dsaidyB/Etch-A-Sketch_Coop_Project/release/eBom Dhyey Bhatt AlumaPower Etch-A-Sketch.xlsx

Total Cost: | $196.98 | < $200
 | Reference | Value | Part Number | Description | Quantity | Unit Cost (CAD) | Total Cost (CAD) | Link | Comments | Status
1 | BT101 | KE_3034TR | 3034TR | BATTERY RETAINER COIN 20MM SMD | 1 | $0.59 | $0.59 | https://www.digikey.ca/en/products/detail/keystone-electronics/3034TR/4499408
2 | C101 | 4.7uF | GRM188Z71C475KE21J | CAP CER 4.7UF 16V X7R 0603 | 1 | $0.21 | $0.21 | https://www.digikey.ca/en/products/detail/murata-electronics/GRM188Z71C475KE21J/16033436
3 | C102, C103, C106, C108, C111, C112, C114 | 100nF | CC0603KRX7R7BB104 | CAP CER 0.1UF 16V X7R 0603 | 7 | $0.01 | $0.07 | https://www.digikey.ca/en/products/detail/yageo/CC0603KRX7R7BB104/302822
4 | C104, C105, C107, C115, C118 | 1uF | CL10B105KO8NNNC | CAP CER 1UF 16V X7R 0603 | 5 | $0.01 | $0.05 | https://www.digikey.ca/en/products/detail/samsung-electro-mechanics/CL10B105KO8NNNC/3886677
5 | C109 | 10pF | C0402C100K5RACTU | CAP CER 10PF 50V X7R 0402 | 1 | $0.06 | $0.06 | https://www.digikey.ca/en/products/detail/kemet/C0402C100K5RACTU/10483038
6 | C110 | 22nF | CL10B223KB8WPNC | CAP CER 0.022UF 50V X7R 0603 | 1 | $0.06 | $0.06 | https://www.digikey.ca/en/products/detail/samsung-electro-mechanics/CL10B223KB8WPNC/5961018
7 | C113, C116, C117, C119, C120 | 10uF | GRM188Z71A106KA73D | CAP CER 10UF 10V X7R 0603 | 5 | $0.25 | $1.25 | https://www.digikey.ca/en/products/detail/murata-electronics/GRM188Z71A106KA73D/13401725
8 | D101 | EE_EAST1616RGBB2 | EAST1616RGBB2 | LED RGB DIFFUSED 4SMD | 1 | $0.35 | $0.35 | https://www.digikey.ca/en/products/detail/everlight-electronics-co-ltd/EAST1616RGBB2/8510360
9 | H101-H108 | MountingHole | N/A |  | 8 |  | $0.00
10 | J101 | SAM_FTSH-107-01-L-DV-K-A_STDC14 | FTSH-107-01-L-DV-K-A | CONN HEADER SMD 14POS 1.27MM | 1 | $4.78 | $4.78 | https://www.digikey.ca/en/products/detail/samtec-inc/FTSH-107-01-L-DV-K-A/7443623 | STDC14
11 | J102 | WE_61304021121 | 61304021121 | CONN HEADER VERT 40POS 2.54MM | 1 | $2.70 | $2.70 | https://www.digikey.ca/en/products/detail/w%C3%BCrth-elektronik/61304021121/4846886
12 | L101, L102 | 600R@100MHz | BLM18AG601SN1D | FERRITE BEAD 600 OHM 0603 1LN | 2 | $0.09 | $0.18 | https://www.digikey.ca/en/products/detail/murata-electronics/BLM18AG601SN1D/584225
13 | R101, R102 | 147R | RC0603FR-07147RL | RES 147 OHM 1% 1/10W 0603 | 2 | $0.01 | $0.02 | https://www.digikey.ca/en/products/detail/yageo/RC0603FR-07147RL/726950
14 | R103 | 1K | RMCF0603FT1K00 | RES 1K OHM 1% 1/10W 0603 | 1 | $0.01 | $0.01 | https://www.digikey.ca/en/products/detail/stackpole-electronics-inc/RMCF0603FT1K00/1761077
15 | R104 | 511R | RC0603FR-07511RL | RES 511 OHM 1% 1/10W 0603 | 1 | $0.01 | $0.01 | https://www.digikey.ca/en/products/detail/yageo/RC0603FR-07511RL/727287
16 | R105, R110, R111 | 10K | RC0603FR-0710KL | RES 10K OHM 1% 1/10W 0603 | 3 | $0.01 | $0.03 | https://www.digikey.ca/en/products/detail/yageo/RC0603FR-0710KL/726880
17 | R106, R107 | TTE_P120PK-Y25BR10K | P120PK-Y25BR10K | POT 10K OHM 1/20W PLASTIC LINEAR | 2 | $1.79 | $3.58 | https://www.digikey.ca/en/products/detail/tt-electronics-bi/P120PK-Y25BR10K/5957454
18 | R108 | 59K | RC0603FR-0759KL | RES 59K OHM 1% 1/10W 0603 | 1 | $0.01 | $0.01 | https://www.digikey.ca/en/products/detail/yageo/RC0603FR-0759KL/727313
19 | R109, R114, R115 | 100K | RC0603FR-07100KL | RES 100K OHM 1% 1/10W 0603 | 3 | $0.01 | $0.03 | https://www.digikey.ca/en/products/detail/yageo/RC0603FR-07100KL/726889
20 | R112, R113 | 23.2K | RC0603FR-0723K2L | RES 23.2K OHM 1% 1/10W 0603 | 2 | $0.01 | $0.02 | https://www.digikey.ca/en/products/detail/yageo/RC0603FR-0723K2L/727068
21 | SW101 | CK_GSPTS004003 | GSPTS004003 | SWITCH TACTILE SPST-NO 0.05A 12V | 1 | $0.28 | $0.28 | https://www.digikey.ca/en/products/detail/c-k/PTS636SM43SMTR-LFS/10071723
22 | SW102 | ESW_RA11131121 | RA11131121 | SWITCH ROCKER SPST 10A 125V | 1 | $0.92 | $0.92 | https://www.digikey.ca/en/products/detail/e-switch/RA11131121/2720267
23 | TP101 | GND | N/A |  | 1 |  | $0.00
24 | TP102 | VCC_3V | N/A |  | 1 |  | $0.00
25 | TP103 | VCC_3V_OUT | N/A |  | 1 |  | $0.00
26 | TP104 | VCC_3V3 | N/A |  | 1 |  | $0.00
27 | TP105 | VCC_5V | N/A |  | 1 |  | $0.00
28 | U101 | STM32L433CCT6 | STM32L433CCT6 | IC MCU 32BIT 256KB FLASH 48LQFP | 1 | $8.21 | $8.21 | https://www.digikey.ca/en/products/detail/stmicroelectronics/STM32L433CCT6/6132750
29 | U102 | TI_TPS2553DBVT | TPS2553DBVT | IC PWR SWITCH N-CHAN 1:1 SOT23-6 | 1 | $1.81 | $1.81 | https://www.digikey.ca/en/products/detail/texas-instruments/TPS2553DBVT/1984893
30 | U103 | ST_LIS2DW12TR | LIS2DW12TR | ACCEL 2-16G I2C/SPI 12LGA | 1 | $2.07 | $2.07 | https://www.digikey.ca/en/products/detail/stmicroelectronics/LIS2DW12TR/7348326
31 | U104, U105 | MIC_MCP1253T-33X50I/MS | MCP1253T-33X50I/MS | IC REG CHARGE PUMP PROG 1 8MSOP | 2 | $2.94 | $5.88 | https://www.digikey.ca/en/products/detail/microchip-technology/MCP1253T-33X50I-MS/530263
32 |  |  | 17590 | 6inch HD e-Paper HAT | 1 | $157.85 | $157.85 | https://www.waveshare.com/6inch-HD-e-Paper-HAT.htm |  | Ordered
33 |  |  | #065-3123-6 | CR2032 3V Coin Cell Battey, Long Lasting | 1 | $2.83 | $2.83 | https://www.canadiantire.ca/en/pdp/energizer-6-pk-cr2032-3v-3-volt-lithium-coin-cell-batteries-long-lasting-0653123p.html | 6 pack
34 | L101, L102 |  | BLM18KG121TN1D | FERRITE BEAD 120 OHM 0603 1LN | 2 | $0.10 | $0.20 | https://www.digikey.ca/en/products/detail/murata-electronics/BLM18KG121TN1D/1982762
35 | J102 |  | PPPC202LFBN-RC | CONN HDR 40POS 0.1 GOLD PCB | 1 | $2.92 | $2.92 | https://www.digikey.ca/en/products/detail/sullins-connector-solutions/PPPC202LFBN-RC/810259
 |  |  |  |  |  |  | $0.00
 |  |  |  |  |  |  | $0.00
 |  |  |  |  |  |  | $0.00
 |  |  |  |  |  |  | $0.00
 |  |  |  |  |  |  | $0.00
 |  |  |  |  |  |  | $0.00
 |  |  |  |  |  | Total Cost (CAD): | $196.98
