dsaidyB/Etch-A-Sketch_Coop_Project/etch_a_sketch/etch_a_sketch.kicad_pcb

## KiCad design etch_a_sketch/etch_a_sketch.kicad_pcb (2025-12-12)

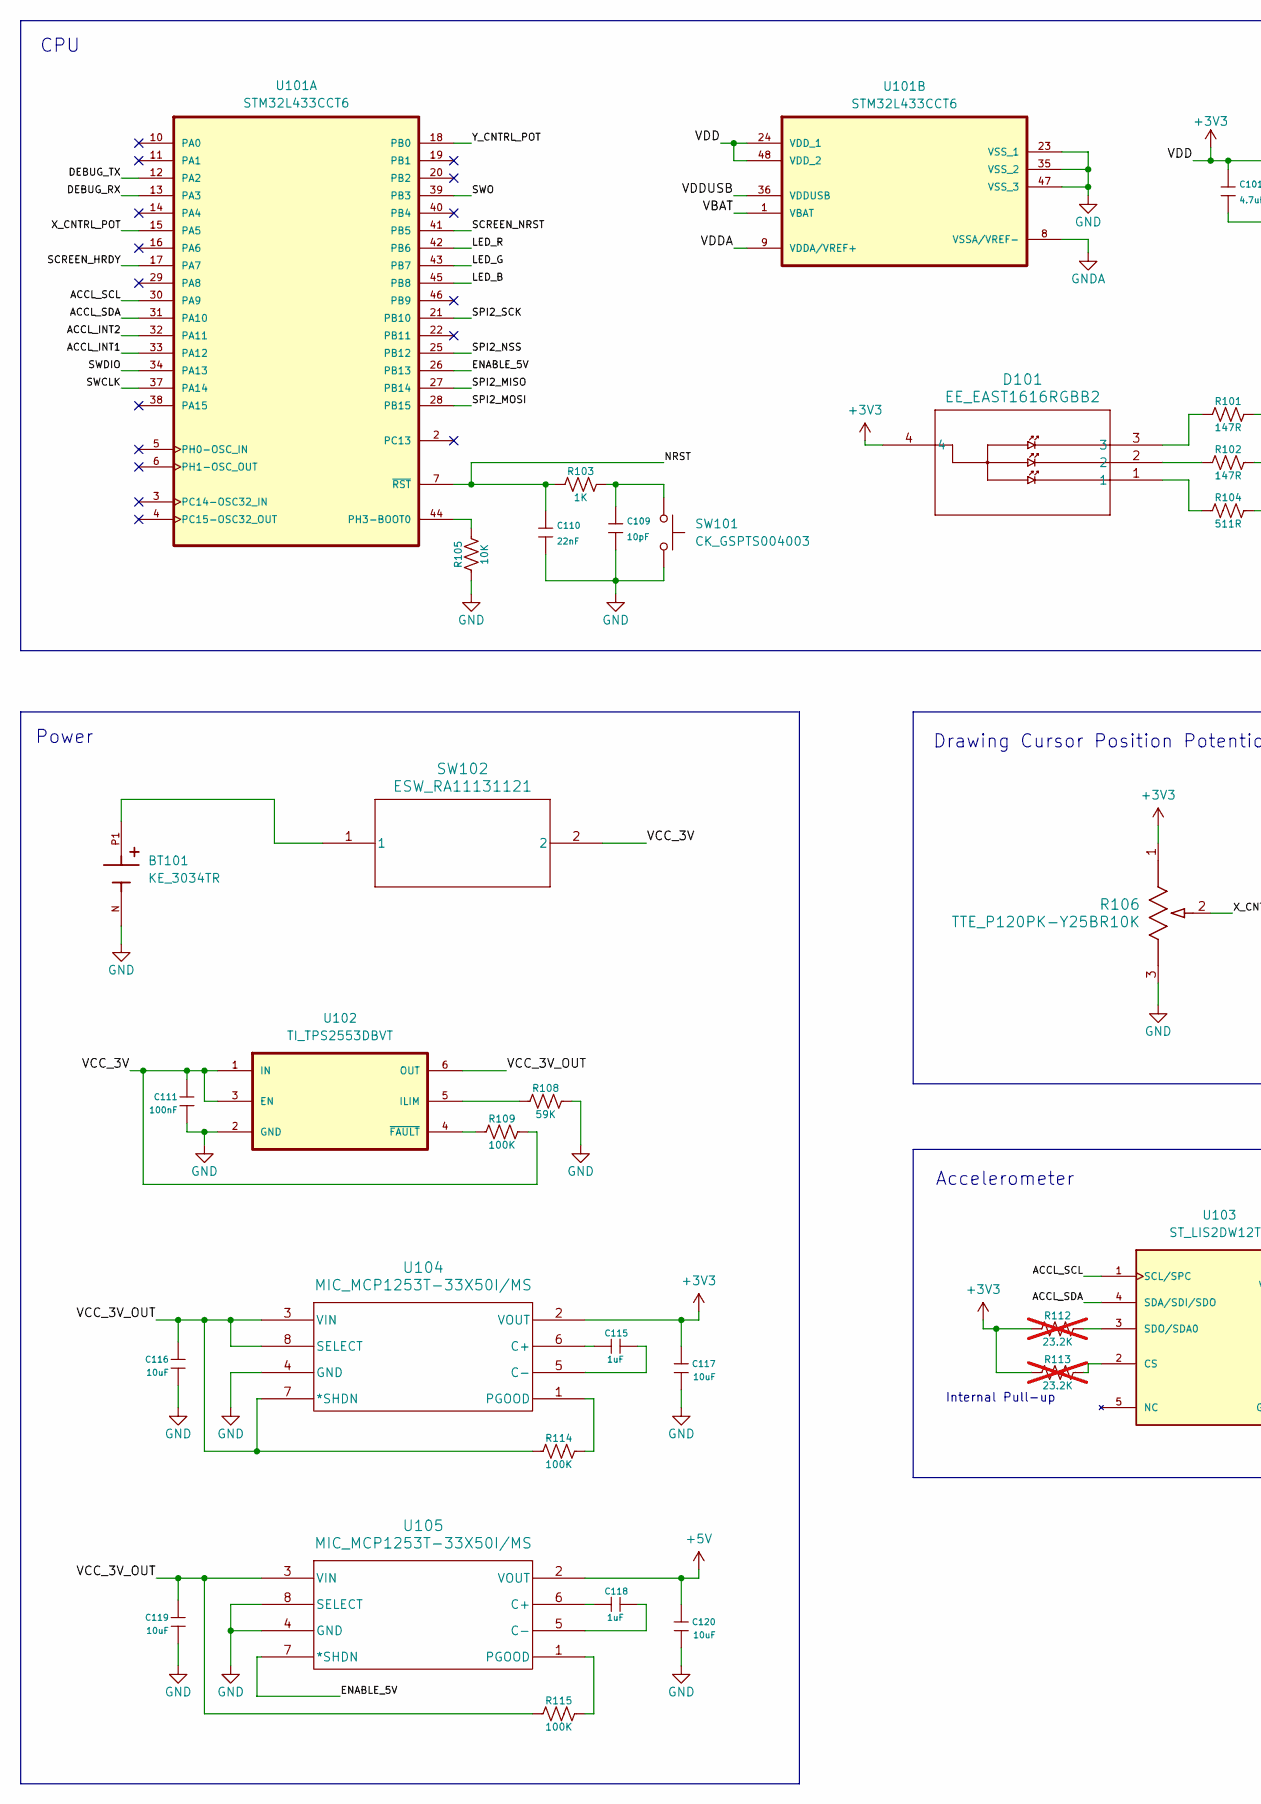
[picture p1: schematic etch_a_sketch.kicad_sch, Dhyey B. Etch-A-Sketch AlumaPower Co-op Project, part in row 1, column 1]

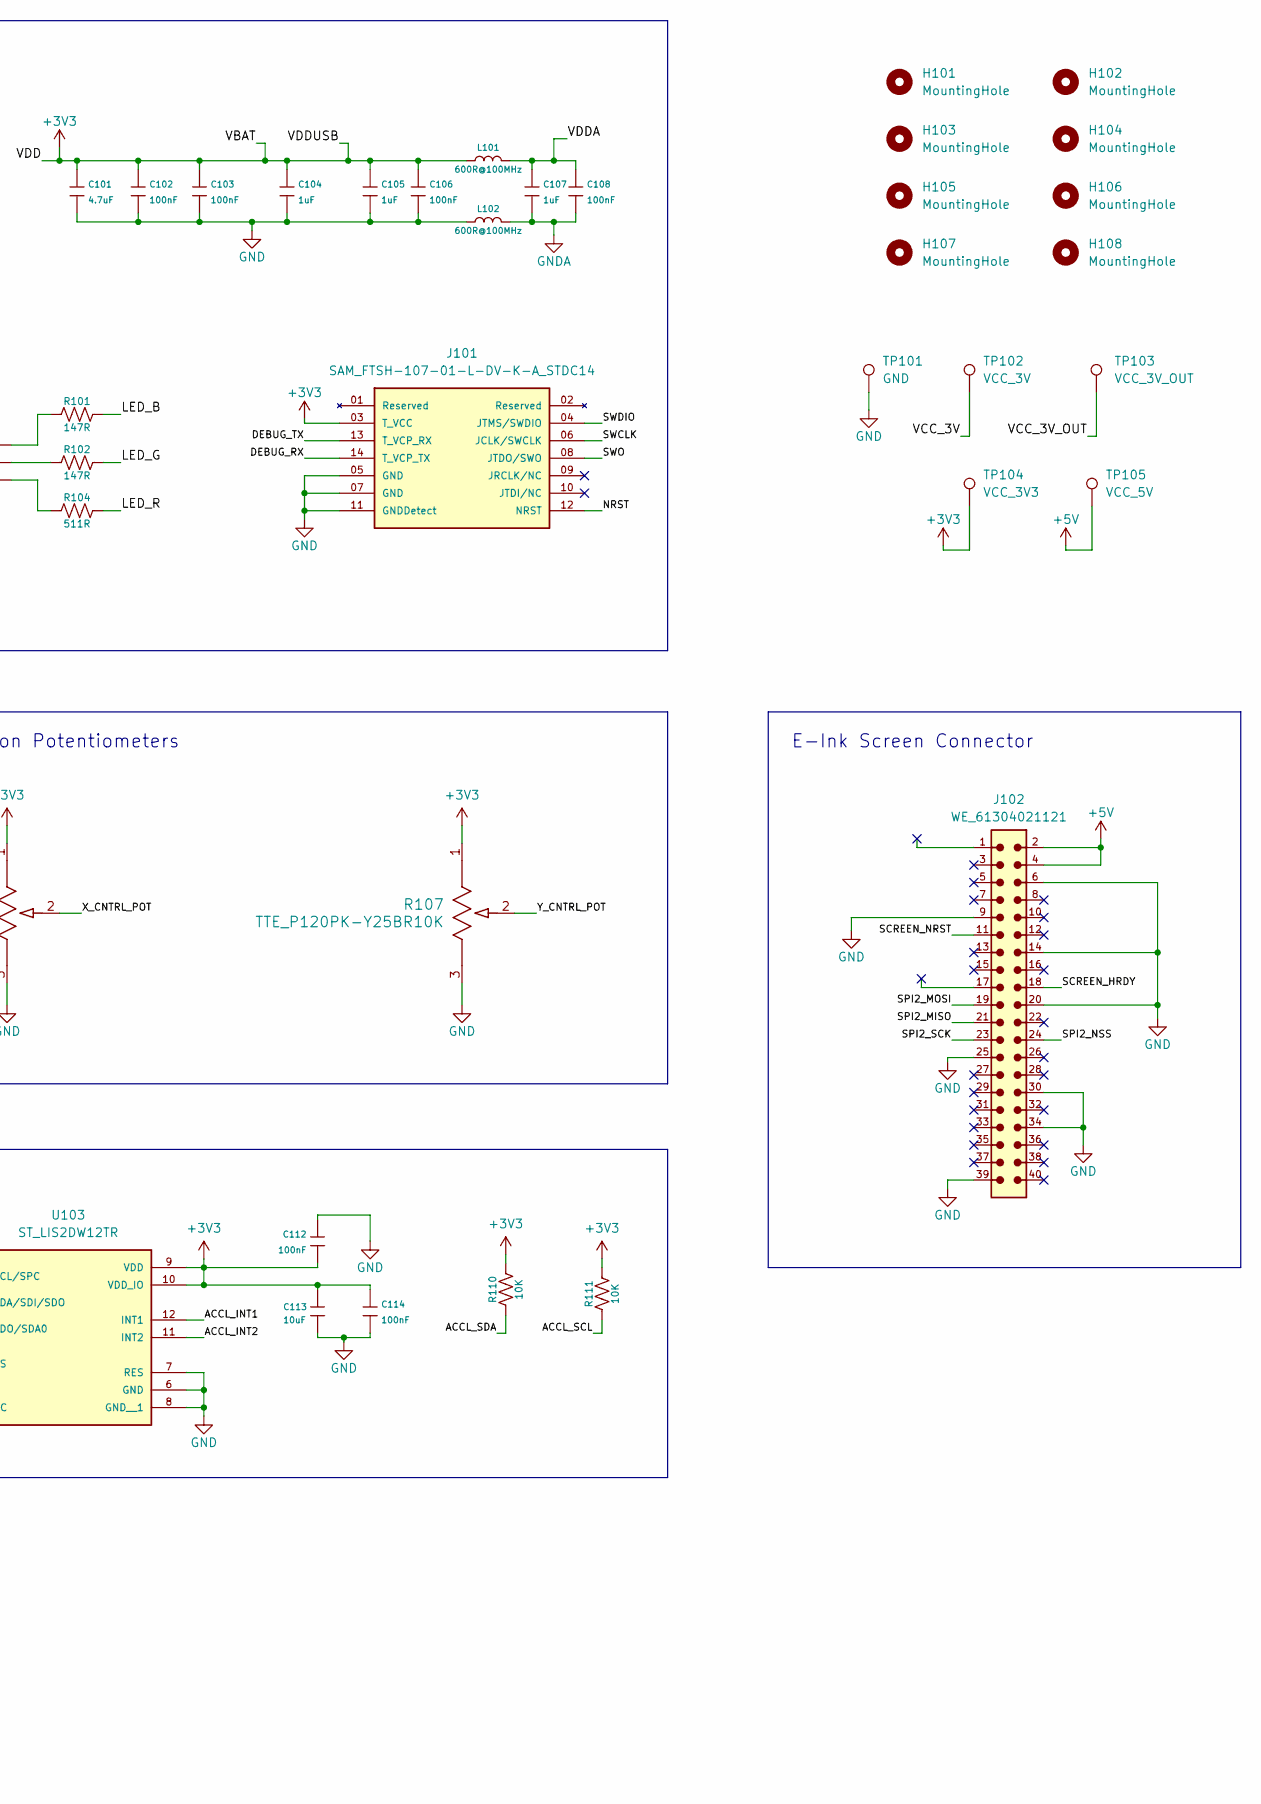
[picture p2: schematic etch_a_sketch.kicad_sch, Dhyey B. Etch-A-Sketch AlumaPower Co-op Project, part in row 1, column 2]

Parts:
BT101: KE_3034TR; PARTREV E; DigiKey_Part_Number 36-3034CT-ND
C101: 4.7uF; 0603_1608Metric
C102, C103, C106, C108, C111, C112, C114: 100nF; 0603_1608Metric
C104, C105, C107, C115, C118: 1uF; 0603_1608Metric
C109: 10pF; 0402_1005Metric
C110: 22nF; 0603_1608Metric
C113, C116, C117, C119, C120: 10uF; 0603_1608Metric
D101: EE_EAST1616RGBB2
H101, H102, H103, H104, H105, H106, H107, H108: MountingHole; MountingHole_3.2mm_M3_ISO14580_Pad_TopBottom
J101: SAM_FTSH-107-01-L-DV-K-A_STDC14; PARTREV H; DigiKey_Part_Number FTSH-107-01-L-DV-K-A-ND
J102: WE_61304021121
L101, L102: 600R@100MHz; 0603_1608Metric
R101, R102: 147R; 0603_1608Metric
R103: 1K; 0603_1608Metric
R104: 511R; 0603_1608Metric
R105, R110, R111: 10K; 0603_1608Metric
R106, R107: TTE_P120PK-Y25BR10K
R108: 59K; 0603_1608Metric
R109, R114, R115: 100K; 0603_1608Metric
R112, R113: 23.2K; 0603_1608Metric; not fitted
SW101: CK_GSPTS004003
SW102: ESW_RA11131121
TP101: GND; TestPoint_THTPad_4.0x4.0mm_Drill2.0mm
TP102: VCC_3V; TestPoint_THTPad_4.0x4.0mm_Drill2.0mm
TP103: VCC_3V_OUT; TestPoint_THTPad_4.0x4.0mm_Drill2.0mm
TP104: VCC_3V3; TestPoint_THTPad_4.0x4.0mm_Drill2.0mm
TP105: VCC_5V; TestPoint_THTPad_4.0x4.0mm_Drill2.0mm
U101: STM32L433CCT6
U102: TI_TPS2553DBVT; TI_TPS2553DBVT_SOT-23-6; DigiKey_Part_Number 296-23990-1-ND
U103: ST_LIS2DW12TR; PARTREV 4
U104, U105: MIC_MCP1253T-33X50I/MS; MIC_MCP1253T-33X50IMS

Connections:
+3V3: C101.1, C102.1, C103.1, C104.1, C105.1, C106.1, C112.2, C113.2, C114.1, C117.2, D101.4, J101.03 (T_VCC), L101.1, R106.1, R107.1, R110.2, R111.2, R112.1, R113.1, TP104.1, U101.1 (VBAT), U101.24 (VDD_1), U101.36 (VDDUSB), U101.48 (VDD_2), U103.9 (VDD), U103.10 (VDD_IO), U104.2 (VOUT)
+5V: C120.2, J102.2, J102.4, TP105.1, U105.2 (VOUT)
/ACCL_INT1: U101.33 (PA12), U103.12 (INT1)
/ACCL_INT2: U101.32 (PA11), U103.11 (INT2)
/ACCL_SCL: R111.1, U101.30 (PA9), U103.1 (SCL/SPC)
/ACCL_SDA: R110.1, U101.31 (PA10), U103.4 (SDA/SDI/SDO)
/DEBUG_RX: J101.14 (T_VCP_TX), U101.13 (PA3)
/DEBUG_TX: J101.13 (T_VCP_RX), U101.12 (PA2)
/ENABLE_5V: U101.26 (PB13), U105.7 (*SHDN)
/LED_B: R101.2, U101.45 (PB8)
/LED_G: R102.2, U101.43 (PB7)
/LED_R: R104.2, U101.42 (PB6)
/NRST: C110.1, J101.12 (NRST), R103.1, U101.7 (~RST)
/SCREEN_HRDY: J102.18, U101.17 (PA7)
/SCREEN_NRST: J102.11, U101.41 (PB5)
/SPI2_MISO: J102.21, U101.27 (PB14)
/SPI2_MOSI: J102.19, U101.28 (PB15)
/SPI2_NSS: J102.24, U101.25 (PB12)
/SPI2_SCK: J102.23, U101.21 (PB10)
/SWCLK: J101.06 (JCLK/SWCLK), U101.37 (PA14)
/SWDIO: J101.04 (JTMS/SWDIO), U101.34 (PA13)
/SWO: J101.08 (JTDO/SWO), U101.39 (PB3)
/VCC_3V: C111.2, R109.2, SW102.2, TP102.1, U102.1 (IN), U102.3 (EN)
/VCC_3V_OUT: C116.2, C119.2, R114.1, R115.1, TP103.1, U102.6 (OUT), U104.3 (VIN), U104.7 (*SHDN), U104.8 (SELECT), U105.3 (VIN)
/VDDA: C107.1, C108.1, L101.2, U101.9 (VDDA/VREF+)
/X_CNTRL_POT: R106.2, U101.15 (PA5)
/Y_CNTRL_POT: R107.2, U101.18 (PB0)
GND: BT101.N, C101.2, C102.2, C103.2, C104.2, C105.2, C106.2, C109.2, C110.2, C111.1, C112.1, C113.1, C114.2, C116.1, C117.1, C119.1, C120.1, J101.05 (GND), J101.07 (GND), J101.11 (GNDDetect), J102.6, J102.9, J102.14, J102.20, J102.25, J102.30, J102.34, J102.39, L102.1, R105.1, R106.3, R107.3, R108.2, SW101.2, TP101.1, U101.23 (VSS_1), U101.35 (VSS_2), U101.47 (VSS_3), U102.2 (GND), U103.6 (GND), U103.7 (RES), U103.8 (GND__1), U104.4 (GND), U105.4 (GND), U105.8 (SELECT)
GNDA: C107.2, C108.2, L102.2, U101.8 (VSSA/VREF-)
unnamed: BT101.P1, BT101.P2, SW102.1
unnamed: C109.1, R103.2, SW101.1
unnamed: D101.1, R104.1
unnamed: D101.2, R102.1
unnamed: D101.3, R101.1
unnamed: R105.2, U101.44 (PH3-BOOT0)
unnamed: R108.1, U102.5 (ILIM)
unnamed: R109.1, U102.4 (~FAULT)
unnamed: R113.2, U103.2 (CS)
unnamed: R112.2, U103.3 (SDO/SDA0)
unnamed: C115.1, U104.6 (C+)
unnamed: C115.2, U104.5 (C-)
unnamed: R114.2, U104.1 (PGOOD)
unnamed: C118.1, U105.6 (C+)
unnamed: C118.2, U105.5 (C-)
unnamed: R115.2, U105.1 (PGOOD)

Notes on the sheet:
Internal Pull-up
Drawing Cursor Position Potentiometers
Accelerometer
CPU
Power
E-Ink Screen Connector

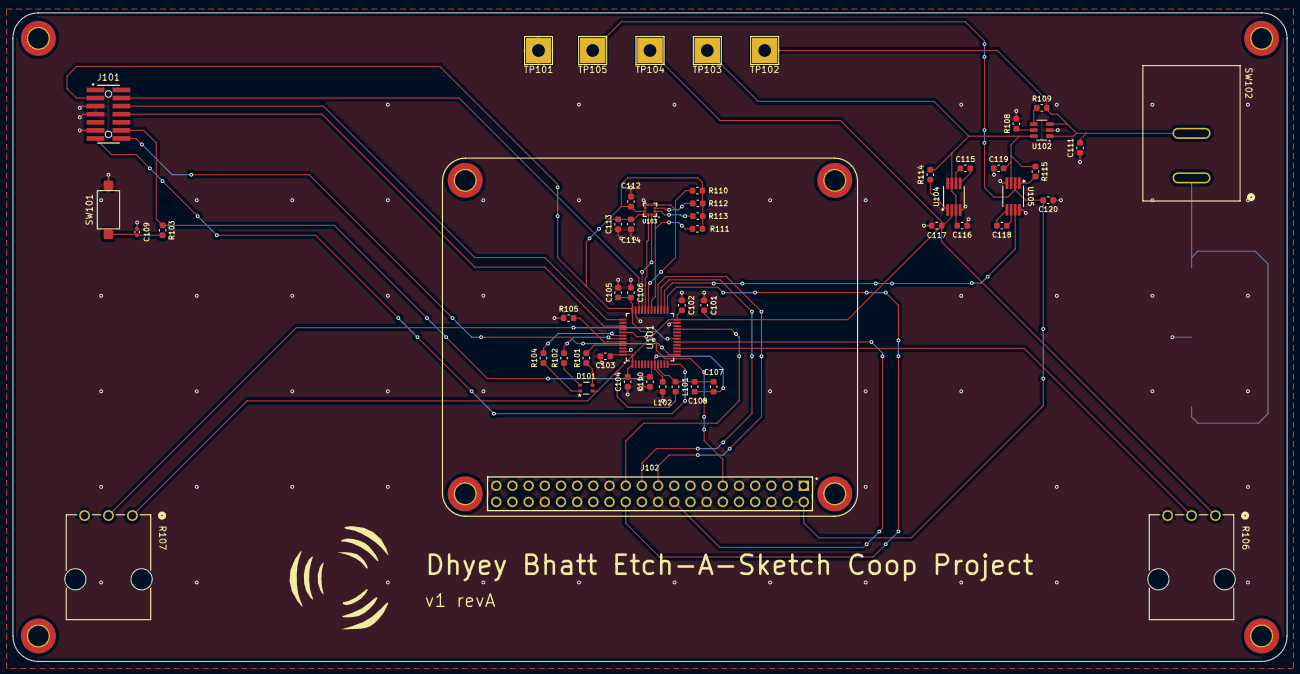
[picture p3: board etch_a_sketch.kicad_pcb from above]

Board: 2 copper layers, 200.0 x 101.8 mm, 61 parts (1 on the bottom side), 45 nets.
