dsaidyB/Etch-A-Sketch_Coop_Project/(commit log)

2025-12-12 revA done
    [etch_a_sketch-B_Cu.gbr, etch_a_sketch-B_Mask.gbr, etch_a_sketch-B_Paste.gbr, etch_a_sketch-B_SilkS.gbr, etch_a_sketch-Edge_Cuts.gbr, etch_a_sketch-F_Cu.gbr, etch_a_sketch-F_Mask.gbr, etch_a_sketch-F_Paste.gbr]
2025-12-12 started BOM
    [eBom Dhyey Bhatt AlumaPower Etch-A-Sketch.xlsx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]
2025-12-12 BOM done
    [eBom Dhyey Bhatt AlumaPower Etch-A-Sketch.xlsx, etch_a_sketch.kicad_pcb]
2025-12-15 updated bom
    [digikey cart.xlsx, eBom Dhyey Bhatt AlumaPower Etch-A-Sketch.xlsx]
2026-01-01 v1 of driver
